suspaceflight/cubesat-telecommand-tx/README.md

# cubesat-telecommand-tx
WIP Telecommand Transmitter for the UoS3 Cubesat
