suspaceflight/cubesat-telecommand-tx/Layout/Modulator_r1/BOM.md

# Modulator Board

| Part Number | Description | Farnell Number | Quantity  | Unit Cost  |
|---|---|---|---:|---:|
| ATMega328P | 8-bit Microcontroller IC | 1715486 | 1 | £2.01 |
| CC1125 | ISM Transceiver IC | 2422924 | 1 | £11.44 |
| FT232RL | USB-UART Interface IC | 1146032 | 1 | £3.09 |
