suspaceflight/cubesat-telecommand-tx/Layout/Modulator_r1/Modulator_r1_BOM.ods

 | Modulator r1 BOM |  |  | Number of Boards
 |  |  |  | 15
Quantity | Description | Component Numbers | Farnell Order Code (if applicable) | To be Sourced Quantity
 | ICs
1 | ATMEGA328P-AU | U1 | 1715486 | 15
1 | CC1125RHBT | U3 | 2422924 | 15
1 | FT232RL | U5 | 1146032 | 15
1 | SIP32509DT-T1-GE3 | U6 | 2361513 | 15
1 | MCP1700T-3302E/TT | U4 | 1296592 | 15
1 | TPS79933QDDCRQ1 | U2 | 2492549 | 15
 | Discretes
4 | Green LED | LED1,LED2,LED3,LED4 | 2062262 | 60
 | Passives
7 | 100nF 0603 | C2, C4, C30, C31, C32, C33, C34 | 1759037 (http://uk.farnell.com/multicomp/mc0603b104k250ct/cap-mlcc-x7r-100nf-25v-0603/dp/1759037) | 105
1 | 100p 0402 | C27 | 1758969 (http://uk.farnell.com/multicomp/mc0402n101j500ct/cap-mlcc-c0g-np0-100pf-50v-0402/dp/1758969) | 15
1 | 10n 0402 | C7 | 8819734 (http://uk.farnell.com/murata/grm155r71e103ka01d/cap-mlcc-x7r-10nf-25v-0402/dp/8819734) | 15
3 | 10nF 0603 | C1, C5, C35 | 1759102 (http://uk.farnell.com/multicomp/mc0603b103k500ct/cap-mlcc-x7r-10nf-50v-0603/dp/1759102) | 45
2 | 12p 0402 | C11, C12 | 1758943 (http://uk.farnell.com/multicomp/mc0402n120j500ct/cap-mlcc-c0g-np0-12pf-50v-0402/dp/1758943) | 30
1 | 15n 0402 | L7 |  | 15
1 | 18R 0402 | R2 |  | 15
1 | 1n8 0402 | C10 |  | 15
1 | 220n 0402 | C6 |  | 15
1 | 22n 0402 | L9 |  | 15
2 | 27n 0402 | L4, L5 |  | 30
1 | 2p2 0402 | C17 |  | 15
1 | 39p 0402 | C16 |  | 15
1 | 43n 0402 | L8 |  | 15
11 | 47n 0402 | C8, C9, C20, C21, C22, C23, C24, C25, C26, C28, C29 | 1828868 | 165
1 | 4u7 0603 | C3 | 2320818 (http://uk.farnell.com/multicomp/mc0603x475k100ct/cap-mlcc-x5r-4-7uf-10v-0603/dp/2320818) | 15
1 | 56K 0402 | R1 |  | 15
2 | 56n 0402 | L3, L6 |  | 30
1 | 56p 0402 | C15 |  | 15
3 | 5p1 0402 | C13, C14, C18 |  | 45
1 | 6p2 0402 | C19 |  | 15
4 | 10K 0603 | R7, R8, R9, R10 | 1652827 (http://uk.farnell.com/vishay-draloric/crcw060310k0fkta/resistor-10k-0-1w-1-0603-smd/dp/1652827) | 60
4 | 68R 0603 | R3, R4, R5, R6 | 1469833 (http://uk.farnell.com/vishay-draloric/crcw060368r0fkea/resistor-0603-68r0-1/dp/1469833) | #REF!
2 | Ferrite Bead 0603 | FB1, FB2 | 2443235 | #REF!
 | Passives
2 | SMA Edge | J1, J2 |  | #REF!
1 | USB Type B Socket | JP2 | 1076665
 | DNF
Total Parts
67
Unique Lines
33
