suspaceflight/cubesat-telecommand-tx/Layout/Modulator_r1/modulator_r1.brd

## EAGLE design Layout/Modulator_r1/modulator_r1.brd (2015-10-27)

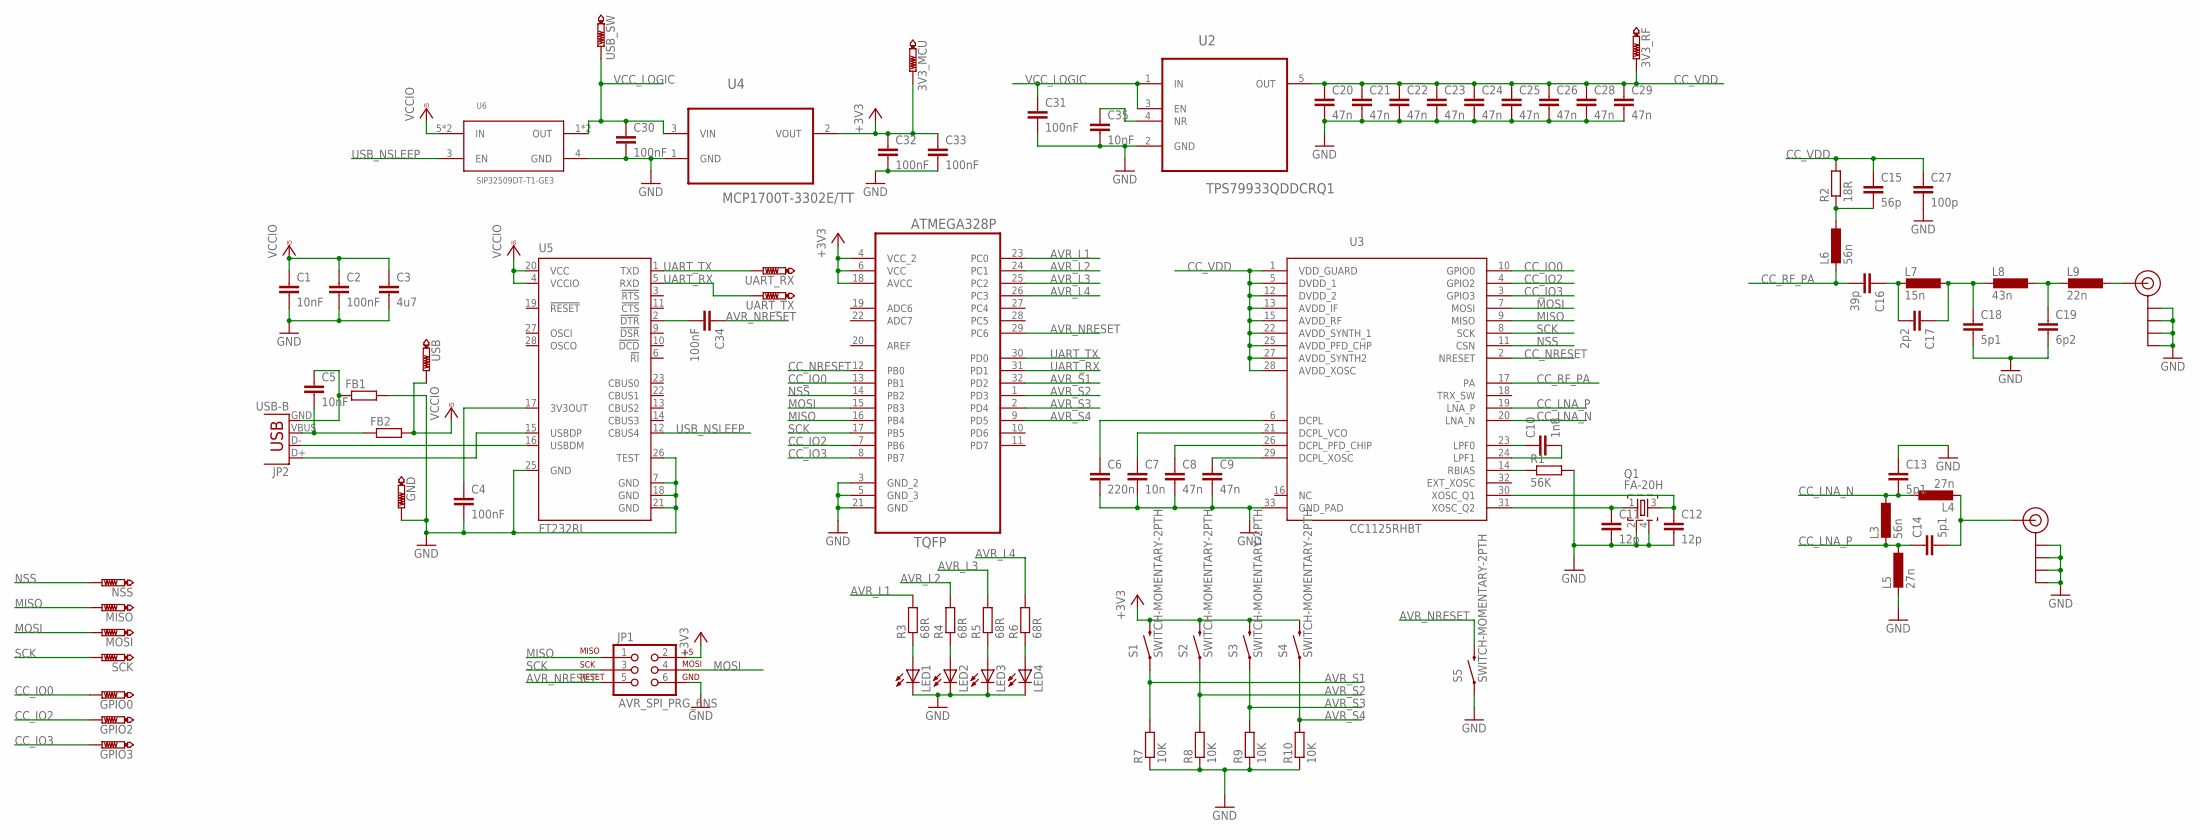
[picture p1: schematic modulator_r1.sch]

Parts:
3V3_MCU, 3V3_RF: PTR1B2,54; B2,54
C1, C5, C35: 10nF; C0603
C2, C4, C30, C31, C32, C33, C34: 100nF; C0603
C3: 4u7; C0603
C6: 220n; C0402
C7: 10n; C0402
C8, C9, C20, C21, C22, C23, C24, C25, C26, C28, C29: 47n; C0402
C10: 1n8; C0402
C11, C12: 12p; C0402
C13, C14, C18: 5p1; C0402
C15: 56p; C0402
C16: 39p; C0402
C17: 2p2; C0402
C19: 6p2; C0402
C27: 100p; C0402
FB1, FB2: R-EU_R0603; R0603
GND: PTR1B2,54; B2,54
GPIO0, GPIO2, GPIO3: PTR1B1,27; B1,27
J$1, J$2: SMA_EDGE; SMA-EDGE
JP1: AVR_SPI_PRG_6NS; 2X3-NS
JP2: USB-B; USB-B-PTH
L3, L6: 56n; R0402
L4, L5: 27n; R0402
L7: 15n; R0402
L8: 43n; R0402
L9: 22n; R0402
LED1, LED2, LED3, LED4: LEDCHIPLED_1206; CHIPLED_1206
MISO: PTR1B1,27; B1,27
MOSI: PTR1B1,27; B1,27
NSS: PTR1B1,27; B1,27
Q1: FA-20H
R1: 56K; R0402
R2: 18R; R0402
R3, R4, R5, R6: 68R; R0603
R7, R8, R9, R10: 10K; R0603
S1, S2, S3, S4, S5: SWITCH-MOMENTARY-2PTH; TACTILE-PTH
SCK: PTR1B1,27; B1,27
U1: ATMEGA328P-AU; QFP80P900X900X120-32N
U2: TPS79933QDDCRQ1; SOT95P280X110-5N
U3: CC1125RHBT; QFN50P500X500X100-32N
U4: MCP1700T-3302E/TT; SOT95P237X112-3N
U5: FT232RL; SSOP28
U6: SIP32509DT-T1-GE3; SOT23-6
UART_RX: PTR1B1,27; B1,27
UART_TX: PTR1B1,27; B1,27
USB: PTR1B2,54; B2,54
USB_SW: PTR1B2,54; B2,54

Connections:
+3V3: 3V3_MCU.TP, C32.1, C33.1, JP1.2, S1.3 (2), S2.3 (2), S3.3 (2), S4.3 (2), U1.4 (VCC_2), U1.6 (VCC), U1.18 (AVCC), U4.2 (VOUT)
AVR_L1: R3.2, U1.23 (PC0)
AVR_L2: R4.2, U1.24 (PC1)
AVR_L3: R5.2, U1.25 (PC2)
AVR_L4: R6.2, U1.26 (PC3)
AVR_NRESET: C34.1, JP1.5, S5.3 (2), U1.29 (PC6)
AVR_S1: R7.2, S1.1, U1.32 (PD2)
AVR_S2: R8.2, S2.1, U1.1 (PD3)
AVR_S3: R9.2, S3.1, U1.2 (PD4)
AVR_S4: R10.2, S4.1, U1.9 (PD5)
CC_IO0: GPIO0.TP, U1.13 (PB1), U3.10 (GPIO0)
CC_IO2: GPIO2.TP, U1.7 (PB6), U3.4 (GPIO2)
CC_IO3: GPIO3.TP, U1.8 (PB7), U3.3 (GPIO3)
CC_LNA_N: C13.2, L3.1, L4.1, U3.20 (LNA_N)
CC_LNA_P: C14.1, L3.2, L5.1, U3.19 (LNA_P)
CC_NRESET: U1.12 (PB0), U3.2 (NRESET)
CC_RF_PA: C16.2, L6.2, U3.17 (PA)
CC_VDD: 3V3_RF.TP, C15.1, C20.1, C21.1, C22.1, C23.1, C24.1, C25.1, C26.1, C27.1, C28.1, C29.1, R2.2, U2.5 (OUT), U3.1 (VDD_GUARD), U3.5 (DVDD_1), U3.12 (DVDD_2), U3.13 (AVDD_IF), U3.15 (AVDD_RF), U3.22 (AVDD_SYNTH_1), U3.25 (AVDD_PFD_CHP), U3.27 (AVDD_SYNTH2), U3.28 (AVDD_XOSC)
GND: C1.2, C2.2, C3.2, C4.2, C6.2, C7.2, C8.2, C9.2, C11.2, C12.2, C13.1, C18.2, C19.2, C20.2, C21.2, C22.2, C23.2, C24.2, C25.2, C26.2, C27.2, C28.2, C29.2, C30.2, C31.2, C32.2, C33.2, C35.2, FB1.2, GND.TP, J$1.GND@0 (GND), J$1.GND@1 (GND), J$1.GND@2 (GND), J$1.GND@3 (GND), J$2.GND@0 (GND), J$2.GND@1 (GND), J$2.GND@2 (GND), J$2.GND@3 (GND), JP1.6, L5.2, LED1.C, LED2.C, LED3.C, LED4.C, Q1.2, Q1.4, R1.2, R7.1, R8.1, R9.1, R10.1, S5.1, U1.3 (GND_2), U1.5 (GND_3), U1.21 (GND), U2.2 (GND), U3.33 (GND_PAD), U4.1 (GND), U5.7 (GND), U5.18 (GND), U5.21 (GND), U5.25 (GND), U5.26 (TEST), U6.4 (GND)
MISO: JP1.1, MISO.TP, U1.16 (PB4), U3.9 (MISO)
MOSI: JP1.4, MOSI.TP, U1.15 (PB3), U3.7 (MOSI)
unnamed: JP2.D-, U5.16 (USBDM)
unnamed: JP2.D+, U5.15 (USBDP)
unnamed: C5.1, FB1.1, JP2.GND
unnamed: C5.2, FB2.1, JP2.VBUS
unnamed: C4.1, U5.17 (3V3OUT)
unnamed: J$2.SIG (SIGNAL), L9.1
unnamed: R1.1, U3.14 (RBIAS)
unnamed: C9.1, U3.29 (DCPL_XOSC)
unnamed: C8.1, U3.26 (DCPL_PFD_CHIP)
unnamed: C7.1, U3.21 (DCPL_VCO)
unnamed: C6.1, U3.6 (DCPL)
unnamed: C10.2, U3.24 (LPF1)
unnamed: C10.1, U3.23 (LPF0)
unnamed: C11.1, Q1.1, U3.31 (XOSC_Q2)
unnamed: C19.1, L8.1, L9.2
unnamed: C12.1, Q1.3, U3.30 (XOSC_Q1)
unnamed: C14.2, J$1.SIG (SIGNAL), L4.2
unnamed: C17.1, C18.1, L7.1, L8.2
unnamed: C16.1, C17.2, L7.2
unnamed: C34.2, U5.2 (!DTR)
unnamed: C15.2, L6.1, R2.1
unnamed: LED1.A, R3.1
unnamed: LED2.A, R4.1
unnamed: LED3.A, R5.1
unnamed: LED4.A, R6.1
unnamed: C35.1, U2.4 (NR)
NSS: NSS.TP, U1.14 (PB2), U3.11 (CSN)
SCK: JP1.3, SCK.TP, U1.17 (PB5), U3.8 (SCK)
UART_RX: U1.31 (PD1), U5.5 (RXD), UART_TX.TP
UART_TX: U1.30 (PD0), U5.1 (TXD), UART_RX.TP
USB_NSLEEP: U5.12 (CBUS4), U6.3 (EN)
VCCIO: C1.1, C2.1, C3.1, FB2.2, U5.4 (VCCIO), U5.20 (VCC), U6.5 (IN), U6.6 (IN), USB.TP
VCC_LOGIC: C30.1, C31.1, U2.1 (IN), U2.3 (EN), U4.3 (VIN), U6.1 (OUT), U6.2 (OUT), USB_SW.TP

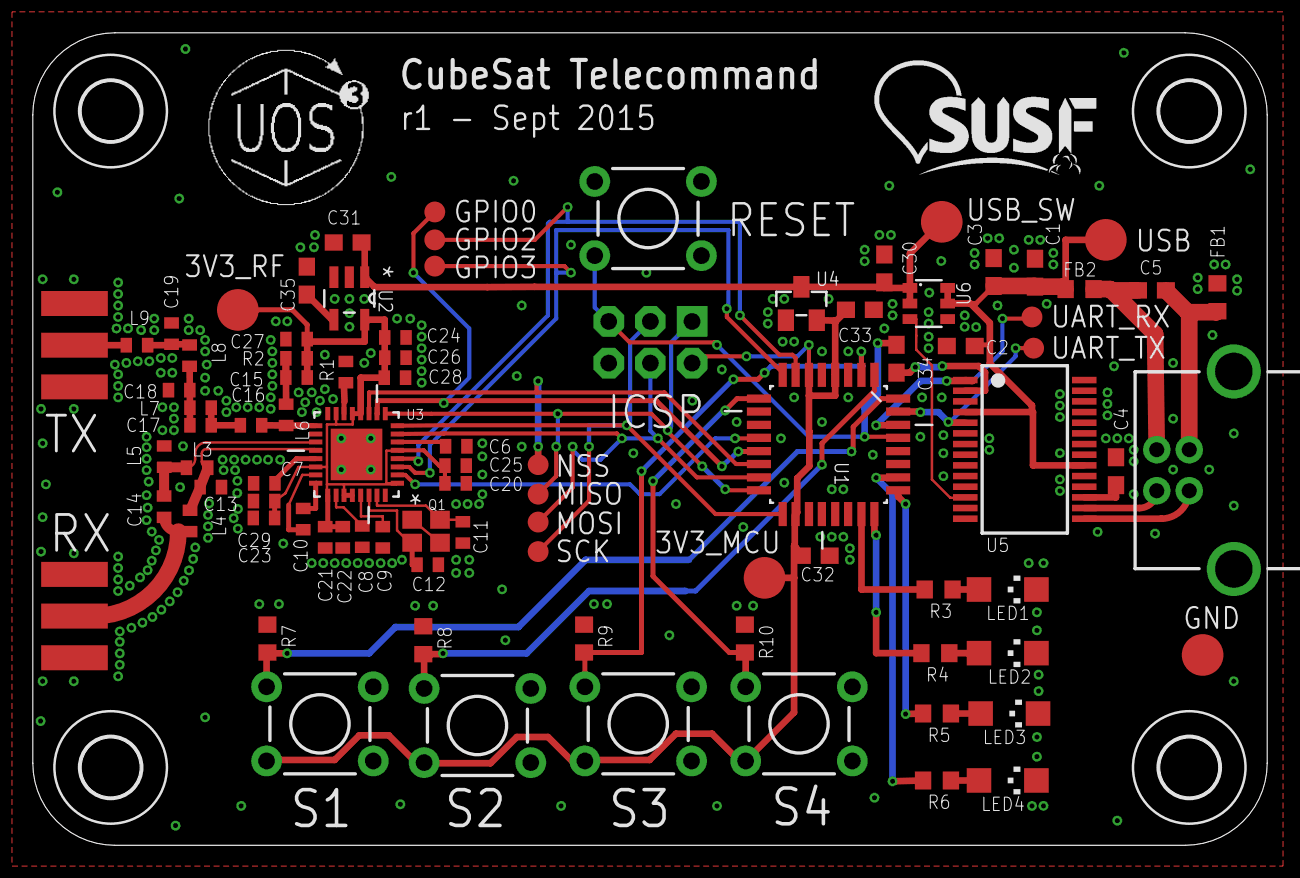
[picture p2: board modulator_r1.brd from above]

Board: 2 copper layers, 75.2 x 49.5 mm, 93 parts (0 on the bottom side), 54 nets.

Other parts of the board:
U$1: SUSF-XSM
U$2, U$3, U$4, U$5: 3,6
