suspaceflight/cubesat-telecommand-tx/Layout/Modulator_r1/Assembly.odt

### USB + AVR

| 4.7uF | C3
| 100nF | C2, C4, C30, C32, C33, C34
| 10nF | C1, C5
| 68R | R3, R4, R5, R6
| 10K | R7, R8, R9, R10
| Ferrite | FB1, FB2
| 10mcd LED | LED1, LED2, LED3, LED4
| ATMega328P | U1
| MCP1700 | U4
| FT232 | U5
| SIP32509 | U6
| 6-pin ICSP | JP1
| USB Socket | JP2
| Tactile Switch | S1, S2, S3, S4
