suspaceflight/cubesat-telecommand-tx/(threads)

Thread 6 (2015-07-27):

Check Subsystem Schematics

philcrump, 2015-07-27:
- [x] FT232
- [x] ATMega328
- [x] CC1125
- - [ ] Attention to RX transmission line

- [x] CC1125 Regulator
- [ ] USB Power Switch

Closed 2015-10-01.

Thread 8 (2015-09-29):

Fatten traces around CC1125 where possible.

philcrump, 2015-09-29:
Traces as narrow as 0.15 can cause issues in manufacturing, and present a higher impedance than thicker traces.

Widen traces where possible.

Closed 2015-09-30.

Thread 9 (2015-09-29):

Couple DTR to AVR Reset to allow serial programming over USB

philcrump, 2015-09-29:
ref: https://www.arduino.cc/en/uploads/Main/Arduino_Uno_Rev3-schematic.pdf

Easy, no downsides, makes sense to have it as a feature.

Closed 2015-09-30.
