suspaceflight/cubesat-telecommand-tx/(commit log)

2015-05-09 Start schematic.
    [modulator_r1.sch]
2015-06-04 Progress on board.
    [modulator_r1.brd, modulator_r1.sch]
2015-06-07 Layout progress.
    [modulator_r1.brd, modulator_r1.sch]
2015-06-10 Add USB power switch, start routing.
    [modulator_r1.brd, modulator_r1.sch]
2015-07-03 Layout Modulator_r1
    [modulator_r1.brd]
2015-07-27 Add switches, general layout churn.
    [modulator_r1.brd, modulator_r1.sch]
2015-09-29 Connected CC_Reset and GPIO0.
    [modulator_r1.brd, modulator_r1.sch]
2015-09-29 Clear up DRC errors.
    [modulator_r1.brd]
2015-09-29 Connect GPIO2/3.
    [modulator_r1.brd, modulator_r1.sch]
2015-09-29 Add test pads.
    [modulator_r1.brd, modulator_r1.sch]
2015-09-29 Tweak labels.
    [modulator_r1.brd]
2015-09-30 Add UoS3 and SUSF logos. Closes #7.
    [modulator_r1.brd]
2015-09-30 Add DTR coupling to reset. Closes #9.
    [modulator_r1.brd, modulator_r1.sch]
2015-09-30 Tweak silkscreen.
    [modulator_r1.brd]
2015-09-30 Fatten some traces. Probably closes #8.
    [modulator_r1.brd]
2015-09-30 Redo RX layout to better match TI Reference.
    [modulator_r1.brd]
2015-09-30 Complete LDO circuit.
    [modulator_r1.brd, modulator_r1.sch]
2015-09-30 Actually line up mounting holes.
    [modulator_r1.brd]
2015-10-01 Change tnames to vector. Closes #10.
    [modulator_r1.brd]
2015-10-27 Add test fw.
    [modulator_r1.brd, modulator_r1.sch]
2015-10-29 Add Assembly and BOM.
    [Modulator_r1_BOM.ods]
